KadrusBAG/VideoConverter/README.md

# VideoConverter
Video converter VGA, DVI-I, HDMI to RCA
