KadrusBAG/VideoConverter/Документация/Э1_Кудрявцев.pdf

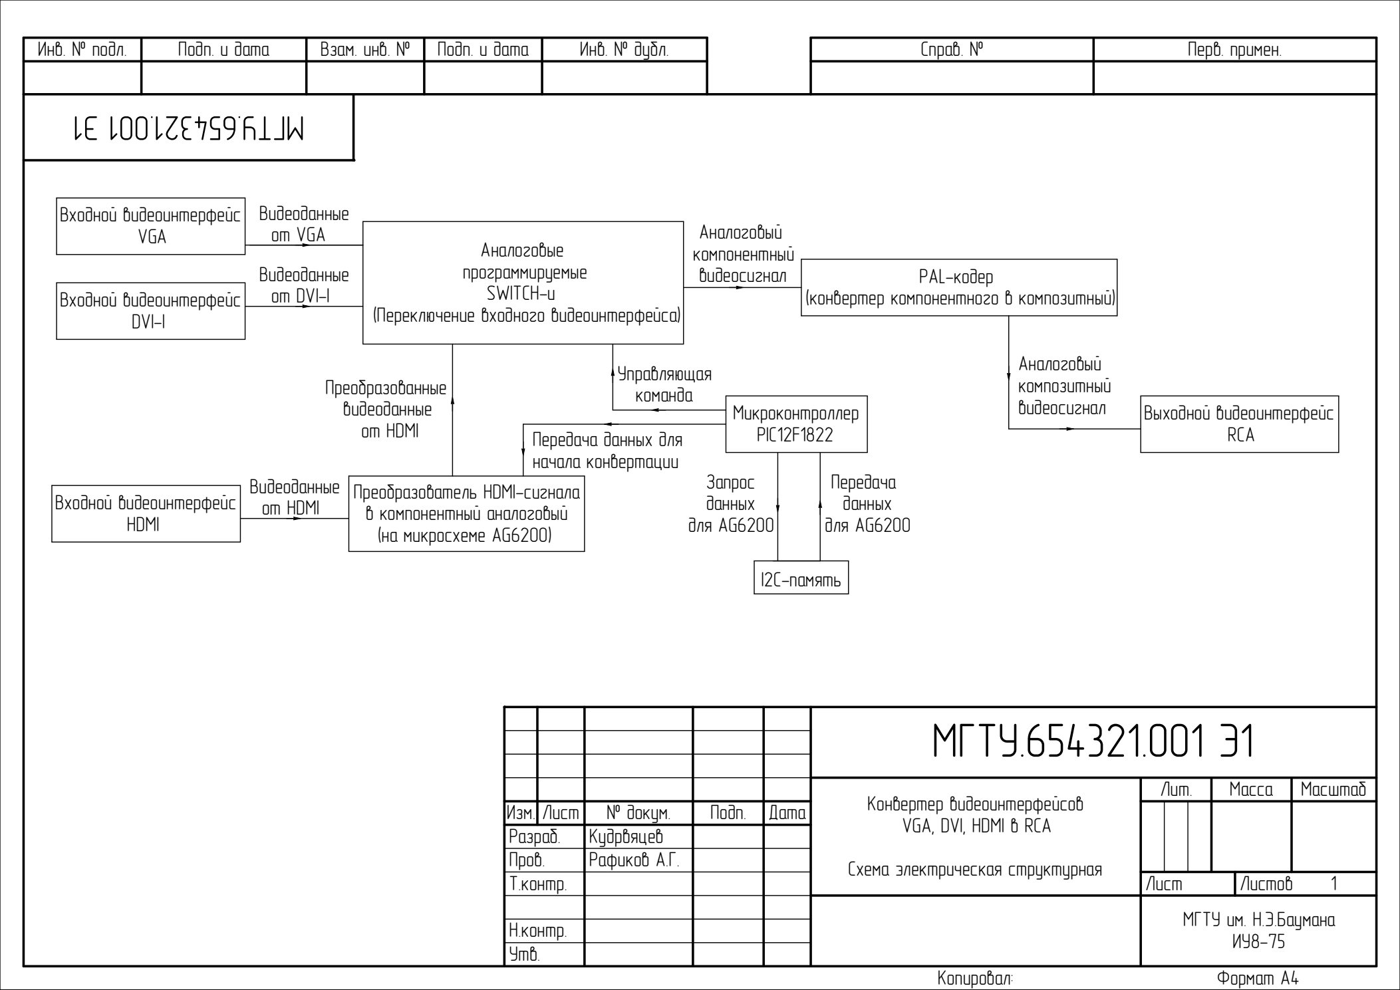
[picture p1: figure]
Разраб.; Кудрвяцев; Пров.; Рафиков А.Г.; МГТУ.654321.001 Э1; МГТУ им. Н.Э.Баумана ИУ8-75; Т.контр.; Лист; Листов 1; Изм. Лист; № докум.; Подп.; Дата; Н.контр. Утв.; Инв. № подл.; Подп. и дата; Взам. инв. №; Инв. № дубл.; Справ. №; Перв. примен.; Копировал:; Формат A4; Входной видеоинтерфейс VGA; Входной видеоинтерфейс DVI-I; Входной видеоинтерфейс HDMI; Микроконтроллер PIC12F1822; PAL-кодер (конвертер компонентного в композитный); Аналоговые программируемые SWITCH-и (Переключение входного видеоинтерфейса); I2C-память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

| | | | Конвертер видеоинтерфейсов VGA, DVI, HDMI в RCA Схема электрическая структурная | Лит. | Масса | Масштаб
