KadrusBAG/VideoConverter/Документация/БСА_Кудрявцев.pdf

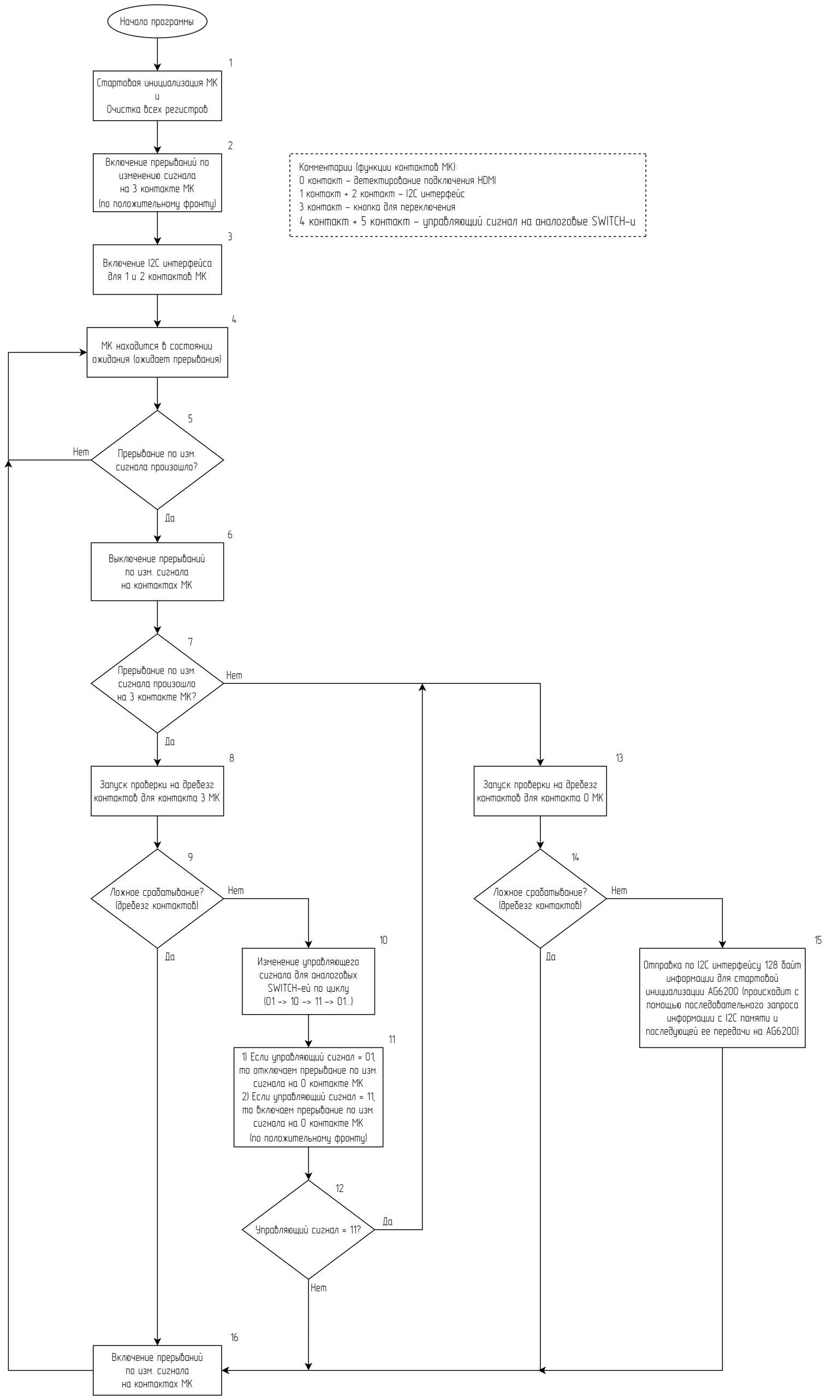
[picture p2: figure]

| | | | МГТУ.654321.001 БСА
| | | | Конвертер видеоинтерфейсов VGA, DVI, HDMI в RCA Схема электрическая прнципиальная | Лит. | Масса | Масштаб
Изм. Лист | № докум. | Подп. | Дата
Разраб. | Кудрявцев
| Пров. | Рафиков А.Г.
Т.контр. | | | | Лист | Листов 1
| | | | МГТУ им. Н.Э.Баумана ИУ8-75
Н.контр.
Утв.
Копировал: | Формат A4
