KadrusBAG/VideoConverter/Документация/ПЭ_Кудрявцев.pdf

Изм. | Лист | № докум. | Подп. | Дата
| | Разраб. | Кудрявцев Рафиков А.Г. | | Конвертер видеоинтерфейсов VGA, DVI, HDMI в RCA Перечень элементов
Пров. | | | | | | 1 3

Н.контр.
Утв.
Копировал | Формат А4

# МГТУ.654321.001 ПЭ

МГТУ им. Н.Э.Баумана
ИУ8-75
Лит. | Лист | Листов Инв. № подл. Подп. и дата Взам. инв. № Инв. № дубл. Подп. и дата Справ. № Перв. примен. | Зона | Поз.
обозначение
Наименование | Кол. | Примечание
| Конденсаторы
C1 | 10мкФ±20% 25В 0603 X5R GRM188R61E106M | 1
C2 | 0.1мкФ±10% 100В 1206 X7R GRM319R72A104KA01D | 1
C3, C4 | 22мкФ±10% 16В 1206 X5R GRM31CR61C226KE15L* | 2
C5 | 10мкФ±20% 25В 0603 X5R GRM188R61E106M | 1
C6 | 0.1мкФ±10% 100В 1206 X7R GRM319R72A104KA01D | 1
C7, C8 | 22мкФ±10% 16В 1206 X5R GRM31CR61C226KE15L* | 2
C9, C10 | 22мкФ±20% 100В ECAP (К50-35) JRB2A220M025006301 | 2 | Конд. электролит.
C11...C14 | 0.1мкФ±10% 100В 1206 X7R GRM319R72A104KA01D | 4
C15 | 220мкФ±20% 100В ECAP (К50-35) JRB2A221M0500130025 | 1 | Конд. электролит.
C16 | 10мкФ±20% 100В ECAP (К50-35) JRB2A100M0250063012 | 1 | Конд. электролит.
C17 | 0.1мкФ±20% 63В WCAP-ATG5 С860020772001 | 1 | Конд. электролит.
C18 | 47пФ±2% 100В 0603 COG GRM1885C2A470GA01D* | 1
C19 | 47мкФ±20% 10В ECAP (К50-35) JRB1A470M0200050011 | 1 | Конд. электролит.
C20, C21 | 10нФ±10% 100В 0603 X7R GRM188R72A103KA01D | 2
C22 | 47мкФ±20% 10В ECAP (К50-35) JRB1A470M0200050011 | 1 | Конд. электролит.
C23 | 0.1мкФ±10% 100В 1206 X7R GRM319R72A104KA01D | 1
C24 | 150пФ±5% 50В 0805 NPO GRM2165C1H151J | 1
C25 | 100пФ±5% 50В 0805 NPO GRM2165C1H101J | 1
C26 | 1мкФ±10% 25В 0603 X7R GRM188R71E105KA12D | 1
C27 | 10мкФ±20% 25В 0603 X5R GRM188R61E106M | 1
C28 | 0.1мкФ±10% 100В 1206 X7R GRM319R72A104KA01D | 1
C29 | 1мкФ±10% 25В 0603 X7R GRM188R71E105KA12D | 1
C30 | 10мкФ±20% 25В 0603 X5R GRM188R61E106M | 1
C31 | 1мкФ±10% 25В 0603 X7R GRM188R71E105KA12D | 1
C32 | 0.1мкФ±10% 100В 1206 X7R GRM319R72A104KA01D | 1
C33 | 4.7мкФ±10% 25В 0805 X5R GRM21BR61E475KA12L | 1

Изм. | Лист | № докум. | Подп. | Дата
МГТУ.654321.001 ПЭ | Лист Инв. № подл. Подп. и дата Взам. инв. № Инв. № дубл. Подп. и дата | 2 Зона | Поз.
| Микросхемы цифровые
DD1 | Quad 2-input exclusive-OR Gate SN74LS86AN С9000004797
DD2 | Микроконтроллер PIC12F1822-I/SN С9000161601
DD3 | Энергозависимая память AT24C01B-PU С9000057151
DD4 | Декодер 2в4 SN74LVC1G139DCTR С8005010195
FU1 | Предохранитель 6В 1.5А miniSMDC150F-2 | SMD15F/33-2
HL1...HL3 | Светодиоды 20мА GNL-3012ED | C9000422971
| Катушки индуктивности
L1 | 4.7 мкГн, 2.5 А, 7X7, EPCOS SMD B82472G6472M000
L2 | 2.2 мкГн, 6.5 А, 10X10, EPCOS SMD B82464G4222M
Q1 | Кварц. резонатор 4.43 МГц HC-49U | С4.433619MHzHC-49U
| Резисторы
R1, R4 | 100кОм±5% SMD 2512 С8004031180 | 2
R2 | 31.6кОм±1% SMD 0805 C8004212638 | 1
R3, R6 | 10.2кОм±1% SMD 0805 C8004212622 | 2
R5 | 4.99кОм±1% SMD 0805 C8004210860 | 1
R7, R8, R12 | 2.2кОм±5% СП3-4БМ С9000175834 | 3 | Резистор перемен.
R9, R10, R11 | 1кОм±10% СП3-19Б С8004213579 | 3 | Резистор перемен.
R13 | 75 Ом±1% SMD 0402 RC0402FR-0775RL | 1
R14 | 16кОм±1% SMD 0402 0402WGF1602TCE | 1
R15 | 47кОм±5% SMD 0402 0402WGJ0473TCE | 1
R16 | 510 Ом±1% SMD 0402 RC0402FR-07510RL | 1
R17, R19 | 10кОм±5% SMD 0805 0805W8J0103T5E | 2
R18 | 1.5кОм±1% SMD 0402 0402WGF1501TCE | 1
R20...R22 | 10кОм±5% SMD 0805 0805W8J0103T5E | 3

Изм. | Лист | № докум. | Подп. | Дата
МГТУ.654321.001 ПЭ | Лист Инв. № подл. Подп. и дата Взам. инв. № Инв. № дубл. Подп. и дата | 3 Зона | Поз.
R23, R25 | 100кОм±5% SMD 2512 С8004031180 | 2
R24, R26 | 10кОм±5% SMD 0805 0805W8J0103T5E | 2
R27 | 4.7кОм±5% SMD 0402 0402WGJ0472TCE | 1
R28...R30 | 270 Ом±1% SMD 0402 RC0402FR-07270RL | 3
VD1...VD3 | Диоды Шоттки 40В 1А/25А 1N5819 | C9000442595 | 3
VT1 | NPN транзистор 45В 0.2А 0.33Вт BC847B | C17914289 | 1
| Микросхемы
U1, U2 | Импульсные стабилизатор ADP2301AUJZ-R7 8002074924 | 2
U3, U4 | Quad analog switch TS5V330CPWR C8003189524 | 2
U5 | Преобразователь компон. аналог. видеосигнала CXA1645 | 1
U6, U7 | Analog switch SN74LVC1G3157DBVR C9000060303 | 2
U8 | Преобразователь цифр. HDMI-сигнала AG6200 | 1
SB1 | Кнопка B3F-3100 OMRON | V79:2366_21808240 | 1
