KadrusBAG/VideoConverter/Документация/СБ_Кудрявцев.pdf

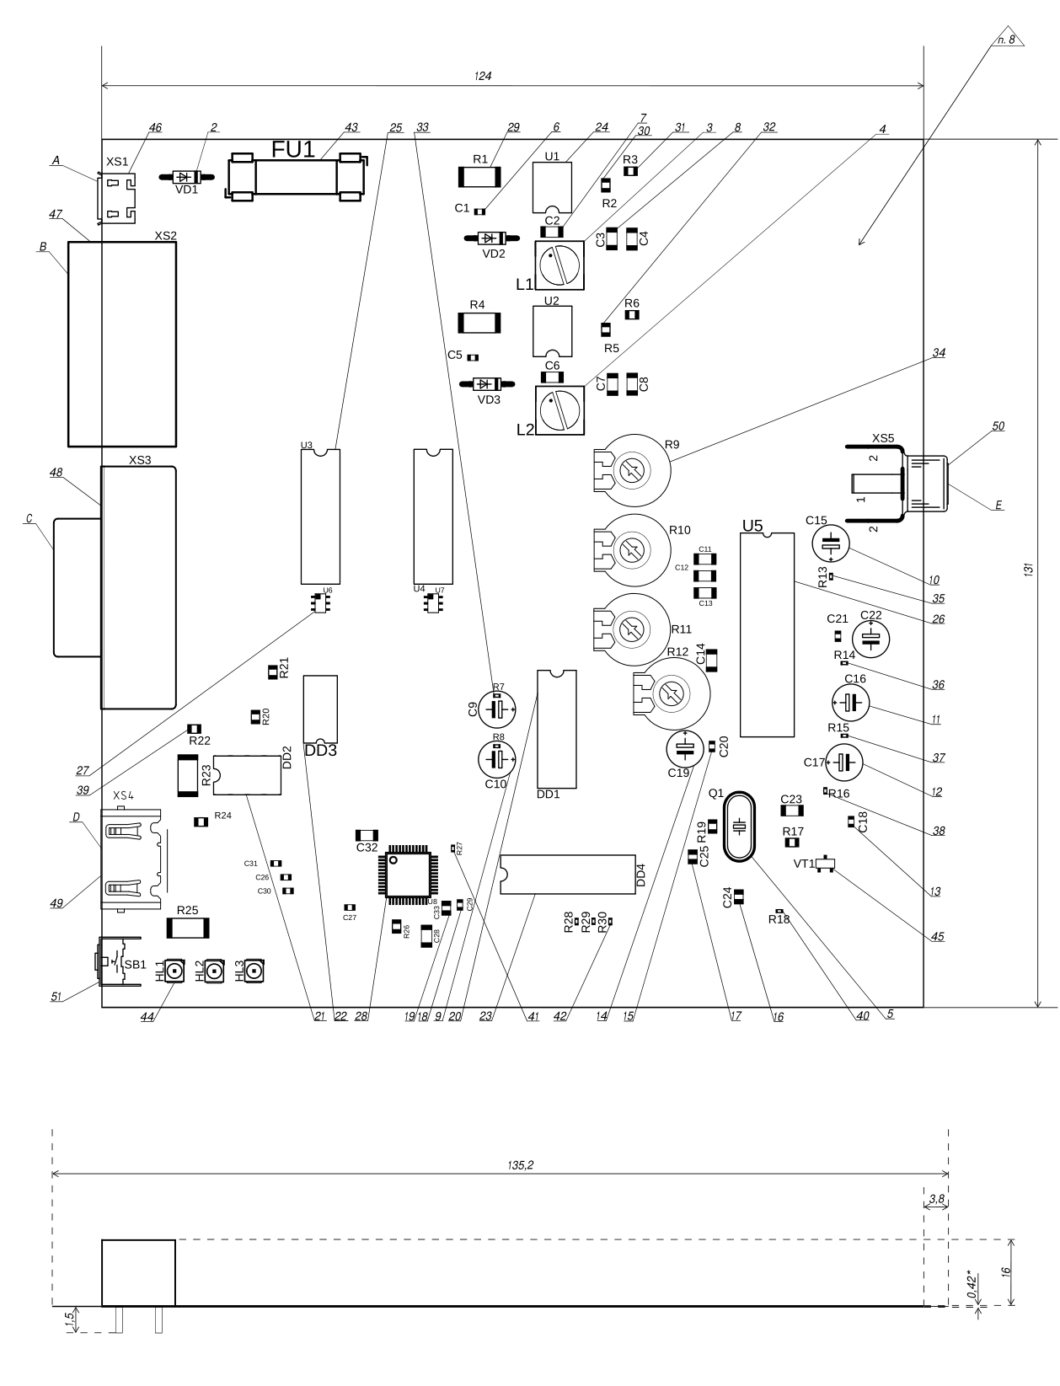
[picture p4: figure]

| | | | МГТУ.654321.001 СБ
| | | | Конвертер видеоинтерфесов VGA, DVI, HDMI в RCA Сборочный чертеж | Лит. | Масса | Масштаб
Изм. Лист | № докум. | Подп. | Дата | | | | | 2:1
Разраб. | Кудрявцев
Пров. | Рафиков А.Г.
Т.контр. | | | | Лист | Листов 1
| | | | МГТУ им. Н.Э.Баумана ИУ8-75
Н.контр.
Утв.
Копировал: | Формат A3
1. *Размеры для справок

2. Габаритные размеры по наибольшим размерам выступающих деталей 3. Монтаж выполнить согласно схеме электрической принципиальной 4. Установку КМП выполнять согласно ГОСТ Р МЭК 61192-1-2010 5. Высота выступающих концов выводов должно быть не более 0.5 мм 6. Печатные проводники условно не показаны 7. Пайку планарных соединений производить согласно ГОСТ 23592-96 8. Пайку объемных соединений производить ПОС-61 ГОСТ 21930-76 согласно ГОСТ 23592-96 9. Контроль пояльных соединений производить визуально оптическим методом
10. Зоны A, B, C, D, E защитить резиновым клеем ИКФ-130 ТУ 38.1051056-82 от попадания лака

### 11. Плату покрыть лаком URETHAN 71 пневматическим распылением в один слой 12. Маркировать заводской номер шрифт 2,5-Пр3 26.020-80 ПФ-115 белая ГОСТ 6465-76 УХ/12 13. Остальные технические требования по ГОСТ Р 56427-2015
