KadrusBAG/VideoConverter/Документация/СПЦ_Кудрявцев.pdf

Изм. | Лист | № докум. | Подп. | Дата
| | Разраб. | Кудрявцев Рафиков А.Г. | | Конвертер видеоинтерфейсов VGA, DVI, HDMI в RCA Спецификация
Пров. | | | | | | 1 6

Н.контр.
Утв.
Копировал | Формат А4

# МГТУ.654321.001 СПЦ

МГТУ им. Н.Э.Баумана
ИУ8-75
Лит. | Лист | Листов Инв. № подл. Подп. и дата Взам. инв. № Инв. № дубл. Подп. и дата Справ. № Перв. примен. | Формат | Зона | Поз. | Обозначение | Наименование | Кол. | Примечание

Документация

А4 | МГТУ.654321.001 ТЗ | Техническое задание
А4 | МГТУ.654321.001 СБ | Сборочный чертеж
А4 | МГТУ.654321.001 Э1 | Схема электрическая структурная
А1 | МГТУ.654321.001 ЭЗ | Схема электрическая принципиальная
А4 | МГТУ.654321.001 ИТП | Исходные тексты программ
А4 | МГТУ.654321.001 ПЭ | Перечень эленментов
А4 | МГТУ.654321.001 ОП | Описание программ
А4 | МГТУ.654321.001 БСА | Блок-схема алгоритма
А4 | МГТУ.654321.001 РПЗ | Расчетно-пояснительная записка

Детали

А3 | 1 | МГТУ.654321.002 | Плата печатная | 1
2 | 1N5819 | 3 | VD1...VD3
| Диоды Шоттки (40В 1А/25А) ST Microelectronics

Катушки индуктивности

3 | 7X7 SMD | 1 | L1
| (4.7 мкГн, 2.5 А) EPCOS
4 | 10X10 SMD | 1 | L2
| (2.2 мкГн, 6.5 А) EPCOS

Изм. | Лист | № докум. | Подп. | Дата
МГТУ.654321.001 СПЦ | Лист Инв. № подл. Подп. и дата Взам. инв. № Инв. № дубл. Подп. и дата | 2 Формат | Зона | Поз. | Обозначение | Наименование | Кол. | Примечание
5 | HC-49U | 1 | Q1
| Кварц. резонатор (4.43 МГц) Китай

Конденсаторы

6 | 0603 X5R | 4 | C1, C5
| (10мкФ±20%) Murata Manufacturing | | C27, C30
7 | 1206 X7R | | C2, C6
| (0.1мкФ±10%) Murata Manufacturing | | C11...C14
| | 9 C23, C28, C32
8 | 1206 X5R | 4 | C3, C4
| (22мкФ±10%) Murata Manufacturing | | C7, C8
9 | ECAP (К50-35) | 2 | C9, C10
| (22мкФ±20%) JB
10 | ECAP (К50-35) | 1 | C15
| (220мкФ±20%) JB
11 | ECAP (К50-35) | 1 | C16
| (10мкФ±20%) JB
12 | WCAP-ATG5 | 1 | С17
| (0.1мкФ±20%) Wurth Elektronik
13 | 0603 COG | 1 | С18
| (47пФ±20%) Murata Manufacturing

МГТУ.654321.001 СПЦ | Лист Инв. № подл. Подп. и дата Взам. инв. № Инв. № дубл. Подп. и дата | 3 Формат | Зона | Поз. | Обозначение | Наименование | Кол. | Примечание
14 | ECAP (К50-35) | 2 | C19, C22
| (47мкФ±20%) JB
15 | 0603 X7R | 2 | C20, C21
| (10нФ±10%) Murata Manufacturing
16 | 0805 NPO | 1 | C24
| (150пФ±5%) Murata Manufacturing
17 | 0805 NPO | 1 | C25
| (100пФ±5%) Murata Manufacturing
18 | 0603 X7R | 3 | C26, C29, C31
| (1мкФ±10%) Murata Manufacturing
19 | 0805 X5R | 1 | C33
| (4.7мкФ±10%) Murata Manufacturing

Микросхемы

20 | SN74LS86AN | 1 | DD1
| (Quad 2-input exclusive-OR Gate) Texas Instruments
21 | PIC12F1822-I/SN | 1 | DD2
| (MCU) Microchip Technology
22 | AT24C01B-PU | 1 | DD3
| (I2C EEPROM) Atmel

МГТУ.654321.001 СПЦ | Лист Инв. № подл. Подп. и дата Взам. инв. № Инв. № дубл. Подп. и дата | 4 Формат | Зона | Поз. | Обозначение | Наименование | Кол. | Примечание
23 | SN74LVC1G139DCTR | 1 | DD4
| (Decoder) Texas Instruments
24 | ADP2301AUJZ-R7 | 2 | U1, U2
| (Стабилизатор напряжения) Analog Devices
| | 2
25 | TS5V330CPWR | | U3, U4
| (Analog switch) Texas Instruments
26 | CXA1645 | 1 | U5
| (Преобразователь компон. аналог. видеосигнала)
27 | SN74LVC1G3157DBVR | 2 | U6, U7
| (Analog switch) Texas Instruments
28 | AG6200 | 1 | U8
| (Преобразователь цифр. HDMI-сигнала)

Резисторы

29 | SMD 2512 | 4 | R1, R4
| (100кОм±5%) Тайвань | | R23, R25
30 | SMD 0805 | 1 | R2
| (31.6кОм±1%) Тайвань
31 | SMD 0805 | 2 | R3, R6
| (10.2кОм±1%) Тайвань

МГТУ.654321.001 СПЦ | Лист Инв. № подл. Подп. и дата Взам. инв. № Инв. № дубл. Подп. и дата | 5 Формат | Зона | Поз. | Обозначение | Наименование | Кол. | Примечание
32 | SMD 0805 | R5
| (4.99кОм±1%) Тайвань
33 | СП3-4БМ | 3 | R7, R8, R12
| (2.2кОм±5%) Россия
34 | СП3-19Б | 3 | R9, R10, R11
| (1кОм±10%) Россия
35 | SMD 0402 | R13
| (75 Ом±1%) Тайвань
36 | SMD 0402 | 1 | R14
| (16кОм±1%) Тайвань
37 | SMD 0402 | 1 | R15
| (47кОм±5%) Тайвань
38 | SMD 0402 | 1 | R16
| (510 Ом±1%) Тайвань
39 | SMD 0805 | | R17, R19
| (10кОм±5%) Тайвань | | R20...R22
| | 7 R24, R26
40 | SMD 0402 | 1 | R18
| (1.5кОм±1%) Тайвань
41 | SMD 0402 | 1 | R27
| (4.7кОм±5%) Тайвань

МГТУ.654321.001 СПЦ | Лист Инв. № подл. Подп. и дата Взам. инв. № Инв. № дубл. Подп. и дата | 6 Формат | Зона | Поз. | Обозначение | Наименование | Кол. | Примечание
42 | SMD 0402 | 3 | R28...R30
| (270 Ом±1%) Тайвань
43 | miniSMDC150F-2 | 1 | FU1
| Предохранитель (6В 1.5А) Littelfuse
44 | GNL-3012ED | 3 | HL1...HL3
| Светодиоды (20мА) G-nor Electronics
45 | BC847B | 1 | VT1
| Транзистор (45В 0.2А 0.33Вт) Nexperia

Разъемы

46 | Micro-USB type B | 1 | XS1
47 | VGA (Видеоразъем) | 1 | XS2
48 | DVI-I (Видеоразъем) | 1 | XS3
49 | HDMI (Видеоразъем) | 1 | XS4
50 | RCA jack (Видеоразъем) | 1 | XS5
51 | B3F-3100 | 1 | SB1
| Кнопка (Omron)
