KadrusBAG/VideoConverter/Документация/Э3_Кудрявцев.pdf

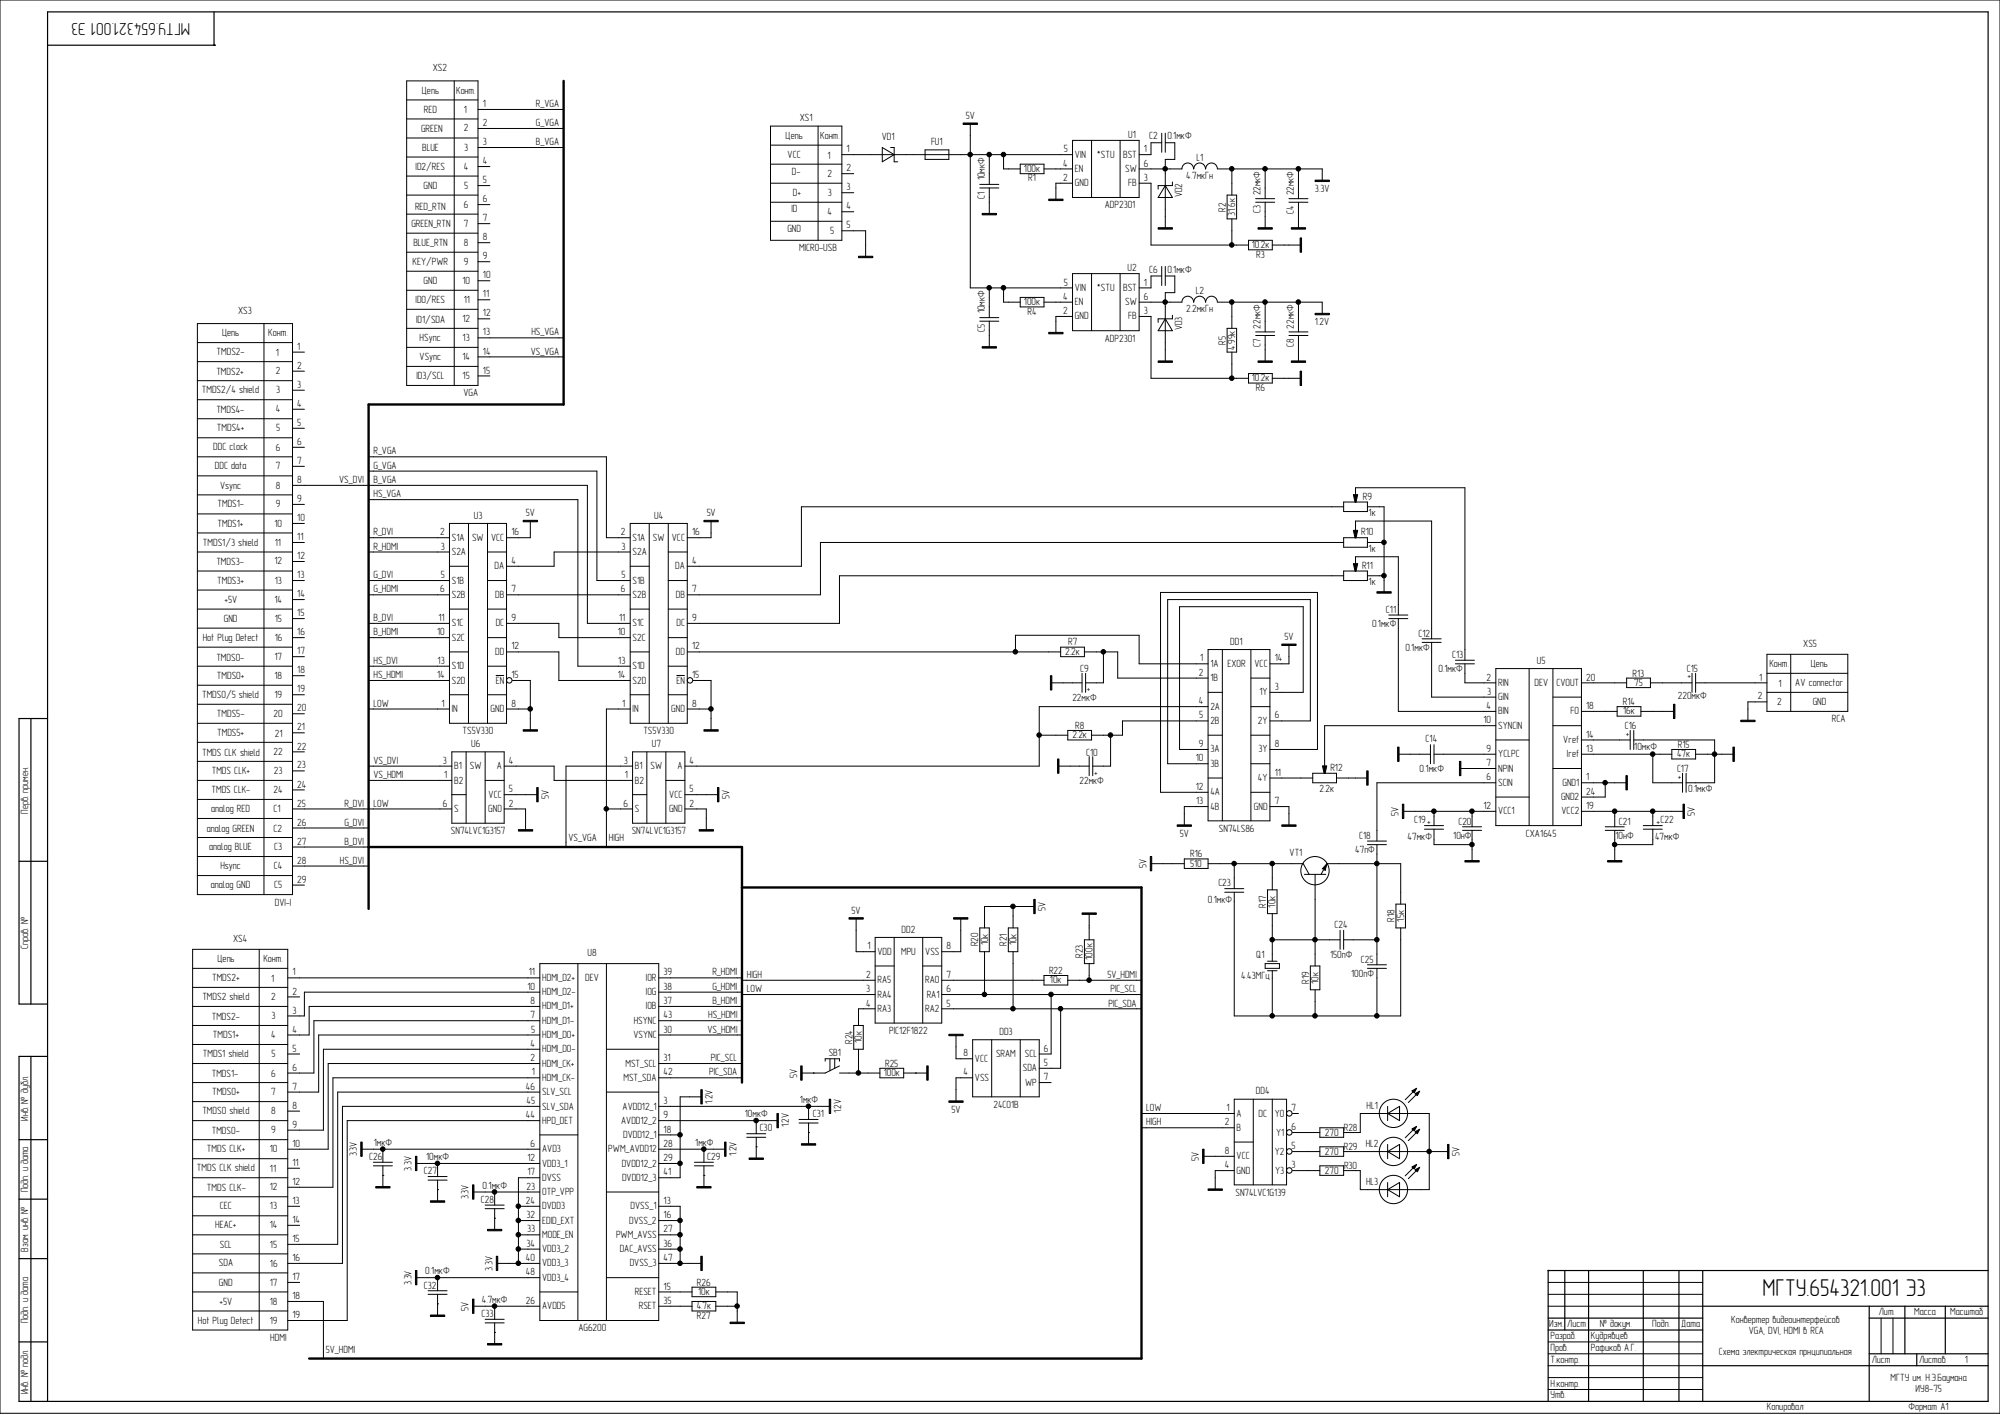
[picture p5: page 1]

Цепь | Конт.
RED | 1
GREEN | 2

BLUE_RTN | 8
KEY/PWR | 9

TMDS2/4 shield | 3 | VGA
TMDS4- | 4
TMDS4+ | 5
DDC clock | 6

analog GREEN | C2
analog BLUE | C3

38 IOG G_HDMI | LOW 3 | 6 | 10к | PIC_SCL

TMDS2 shield | 2 | 3 | 8 | 37 IOB B_HDMI | 4 | PIC_SDA
TMDS2- | 3 | | 7 | 43 HSYNC HS_HDMI

Конвертер видеоинтерфейсов
VGA, DVI, HDMI в RCA

Разраб. | Кудрявцев
Пров. | Рафиков А.Г.
Т.контр. | | Лист | Листов 1

Н.контр.
Утв.

МГТУ им. Н.Э.Баумана ИУ8-75
