KadrusBAG/VideoConverter/(list of files, drawings)

Other design files:
Моделирование/PIC12F1822-WORK.pdsprj
