KadrusBAG/VideoConverter/Разводка ПП/Converter/Scheme.brd

## EAGLE design Разводка ПП/Converter/Scheme.brd (2021-03-14)

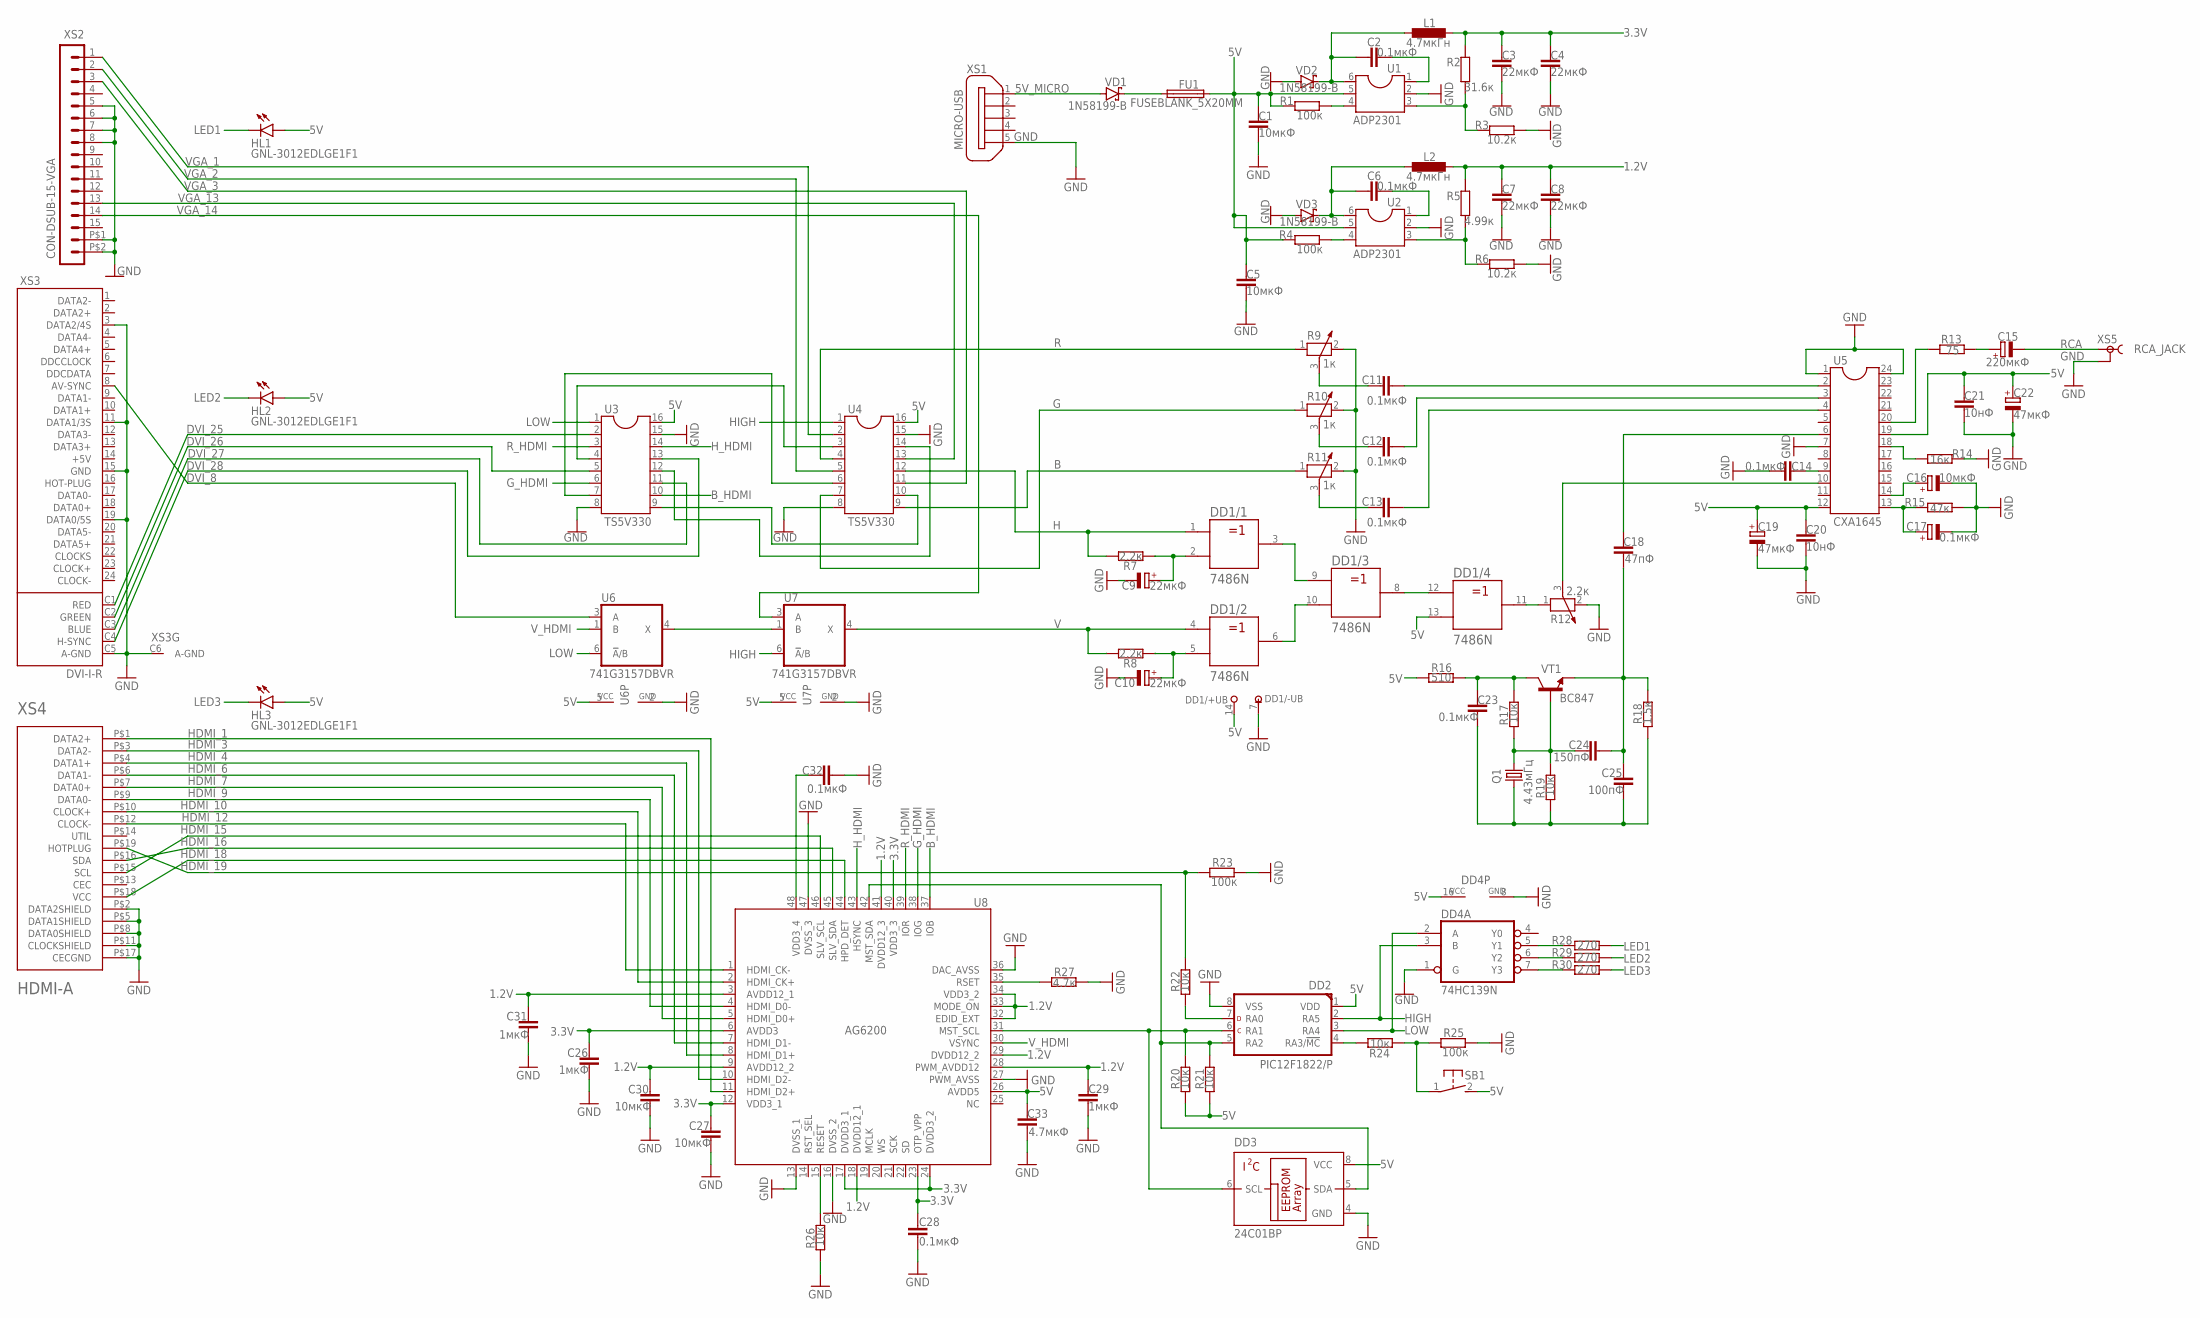
[picture p6: schematic Scheme.sch]

Parts:
C1, C5, C27, C30: 10мкФ; C0603
C2, C6, C11, C12, C13, C14, C23, C28, C32: 0.1мкФ; C1206
C3, C4, C7, C8: 22мкФ; C1206
C9, C10: 22мкФ; E2,5-6E
C15: 220мкФ; E2,5-6E
C16: 10мкФ; E2,5-6E
C17: 0.1мкФ; E2,5-6E
C18: 47пФ; C0603
C19, C22: 47мкФ; E2,5-6E
C20, C21: 10нФ; C0603
C24: 150пФ; C0805
C25: 100пФ; C0805
C26, C29, C31: 1мкФ; C0603
C33: 4.7мкФ; C0805
DD1: 7486N; DIL14
DD2: PIC12F1822/P; DIL8-P
DD3: 24C01BP; DIL8
DD4: 74HC139N; DIL16
FU1: FUSEBLANK_5X20MM; FUSE_HOLDER_5X20MM
HL1, HL2, HL3: GNL-3012EDLGE1F1; PLCC2
L1, L2: 4.7мкГн; PIS2816
Q1: 4.43мГц; HC49U-V
R1, R4, R23, R25: 100к; R2512
R2: 31.6к; R0805
R3, R6: 10.2к; R0805
R5: 4.99к; R0805
R7, R8: 2.2к; R0402
R9, R10, R11: 1к; PT-10
R12: 2.2к; PT-10
R13: 75; R0402
R14: 16к; R0402
R15: 47к; R0402
R16: 510; R0402
R17, R19, R20, R21, R22, R24, R26: 10к; R0805
R18: 1.5к; R0402
R27: 4.7к; R0402
R28, R29, R30: 270; R0402
SB1: 31-XX; B3F-31XX
U1, U2: ADP2301; DIL06
U3, U4: TS5V330; DIL16
U5: CXA1645; DIL24-4
U6, U7: 741G3157DBVR; DBV_R-PDSO-G6
U8: AG6200; PLCC-48
VD1, VD2, VD3: 1N58199-B; DO41-7.6
VT1: BC847; SOT23-BEC
XS1: MICRO-USB; ZX62D-B-5PA8
XS2: CON-DSUB-15-VGA; 181-015-212-171
XS3: DVI-I-R
XS4: HDMI-A; HDMI_A
XS5: RCA_JACK; TOBU3

Connections:
1.2V: C7.1, C8.1, C29.1, C30.1, C31.1, L2.2, R5.2, U8.3 (AVDD12_1), U8.9 (AVDD12_2), U8.18 (DVDD12_1), U8.28 (PWM_AVDD12), U8.29 (DVDD12_2), U8.32 (EDID_EXT), U8.33 (MODE_ON), U8.34 (VDD3_2), U8.41 (DVDD12_3)
3.3V: C3.1, C4.1, C26.1, C27.1, C28.1, L1.2, R2.2, U8.6 (AVDD3), U8.12 (VDD3_1), U8.17 (DVDD3_1), U8.23 (OTP_VPP), U8.24 (DVDD3_2), U8.40 (VDD3_3)
5V: C1.1, C5.1, C19.+, C20.1, C21.1, C22.+, C33.1, DD1.13 (B), DD1.14 (+UB), DD2.1 (VDD), DD3.8 (VCC), DD4.16 (VCC), FU1.2, HL1.A, HL2.A, HL3.A, R1.1, R4.1, R16.1, R20.1, R21.1, SB1.2 (S), U1.5, U2.5, U3.16, U4.16, U5.12, U5.19, U6.5 (VCC), U7.5 (VCC), U8.26 (AVDD5)
5V_MICRO: VD1.A, XS1.1
+5V: XS3.14 (+5V)
B: R11.1, U4.9
B_HDMI: U3.10, U8.37 (IOB)
DVI_8: U6.3 (A), XS3.8 (AV-SYNC)
DVI_25: U3.2, XS3.C1 (RED)
DVI_26: U3.5, XS3.C2 (GREEN)
DVI_27: U3.11, XS3.C3 (BLUE)
DVI_28: U3.13, XS3.C4 (H-SYNC)
G: R10.1, U4.7
GND: C1.2, C3.2, C4.2, C5.2, C7.2, C8.2, C9.-, C10.-, C14.2, C16.-, C17.-, C19.-, C20.2, C21.2, C22.-, C26.2, C27.2, C28.2, C29.2, C30.2, C31.2, C32.2, C33.2, DD1.7 (-UB), DD2.8 (VSS), DD3.4 (GND), DD4.1 (G), DD4.8 (GND), R3.1, R6.1, R9.2, R10.2, R11.2, R12.2, R14.2, R15.2, R23.2, R25.2, R26.1, R27.2, U1.2, U2.2, U3.8, U3.15, U4.8, U4.15, U5.1, U5.7, U5.24, U6.2 (GND), U7.2 (GND), U8.13 (DVSS_1), U8.16 (DVSS_2), U8.27 (PWM_AVSS), U8.36 (DAC_AVSS), U8.47 (DVSS_3), VD2.A, VD3.A, XS1.5, XS2.5, XS2.6, XS2.7, XS2.8, XS2.P$1 (16), XS2.P$2 (17), XS3.3 (DATA2/4S), XS3.11 (DATA1/3S), XS3.15 (GND), XS3.19 (DATA0/5S), XS3.C5 (A-GND), XS3.C6 (A-GND), XS4.P$2 (DATA2SHIELD), XS4.P$5 (DATA1SHIELD), XS4.P$8 (DATA0SHIELD), XS4.P$11 (CLOCKSHIELD), XS4.P$17 (CECGND), XS5.2, XS5.2@1 (2), XS5.2@2 (2)
G_HDMI: U3.6, U8.38 (IOG)
H: DD1.1 (A), R7.1, U4.12
HDMI_1: U8.11 (HDMI_D2+), XS4.P$1 (DATA2+)
HDMI_3: U8.10 (HDMI_D2-), XS4.P$3 (DATA2-)
HDMI_4: U8.8 (HDMI_D1+), XS4.P$4 (DATA1+)
HDMI_6: U8.7 (HDMI_D1-), XS4.P$6 (DATA1-)
HDMI_7: U8.5 (HDMI_D0+), XS4.P$7 (DATA0+)
HDMI_9: U8.4 (HDMI_D0-), XS4.P$9 (DATA0-)
HDMI_10: U8.2 (HDMI_CK+), XS4.P$10 (CLOCK+)
HDMI_12: U8.1 (HDMI_CK-), XS4.P$12 (CLOCK-)
HDMI_15: U8.46 (SLV_SCL), XS4.P$15 (SCL)
HDMI_16: U8.45 (SLV_SDA), XS4.P$16 (SDA)
HDMI_18: U8.44 (HPD_DET), XS4.P$18 (VCC)
HDMI_19: R22.2, R23.1, XS4.P$19 (HOTPLUG)
HIGH: DD2.2 (RA5), DD4.3 (B), U4.1, U7.6 (!A!/B)
H_HDMI: U3.14, U8.43 (HSYNC)
LED1: HL1.C, R28.2
LED2: HL2.C, R29.2
LED3: HL3.C, R30.2
LOW: DD2.3 (RA4), DD4.2 (A), U3.1, U6.6 (!A!/B)
unnamed: FU1.1, VD1.C
unnamed: C9.+, DD1.2 (B), R7.2
unnamed: C2.1, L1.1, U1.6, VD2.C
unnamed: C10.+, DD1.5 (B), R8.2
unnamed: C2.2, U1.1
unnamed: R2.1, R3.2, U1.3
unnamed: R1.2, U1.4
unnamed: C6.1, L2.1, U2.6, VD3.C
unnamed: C6.2, U2.1
unnamed: R5.1, R6.2, U2.3
unnamed: DD4.5 (Y1), R28.1
unnamed: R4.2, U2.4
unnamed: C11.2, U5.2
unnamed: DD1.3 (Y), DD1.9 (A)
unnamed: DD1.6 (Y), DD1.10 (B)
unnamed: C12.2, U5.3
unnamed: DD1.8 (Y), DD1.12 (A)
unnamed: DD1.11 (Y), R12.1
unnamed: C11.1, R9.3
unnamed: C12.1, R10.3
unnamed: C13.1, R11.3
unnamed: C13.2, U5.4
unnamed: R12.3, U5.10
unnamed: C23.1, R16.2, R17.2, VT1.C
unnamed: C23.2, C25.2, Q1.2, R18.1, R19.1
unnamed: C24.1, Q1.1, R17.1, R19.2, VT1.B
unnamed: C18.2, C24.2, C25.1, R18.2, VT1.E
unnamed: C18.1, U5.6
unnamed: DD4.6 (Y2), R29.1
unnamed: C14.1, U5.9
unnamed: DD4.7 (Y3), R30.1
unnamed: C17.+, R15.1, U5.13
unnamed: C16.+, U5.14
unnamed: R14.1, U5.18
unnamed: R13.1, U5.20
unnamed: U6.4 (X), U7.1 (B)
unnamed: C15.+, R13.2
unnamed: U3.4, U4.3
unnamed: U3.7, U4.6
unnamed: U3.9, U4.10
unnamed: C32.1, U8.48 (VDD3_4)
unnamed: U3.12, U4.14
unnamed: R26.2, U8.15 (RESET)
unnamed: R27.1, U8.35 (RSET)
unnamed: DD2.6 (RA1), DD3.6 (SCL), R20.2, U8.31 (MST_SCL)
unnamed: DD2.5 (RA2), DD3.5 (SDA), R21.2, U8.42 (MST_SDA)
unnamed: DD2.7 (RA0), R22.1
unnamed: DD2.4 (RA3/!MC!), R24.2
unnamed: R24.1, R25.1, SB1.1
R: R9.1, U4.4
RCA: C15.-, XS5.1
R_HDMI: U3.3, U8.39 (IOR)
V: DD1.4 (A), R8.1, U7.4 (X)
VGA_1: U4.2, XS2.1
VGA_2: U4.5, XS2.2
VGA_3: U4.11, XS2.3
VGA_13: U4.13, XS2.13
VGA_14: U7.3 (A), XS2.14
V_HDMI: U6.1 (B), U8.30 (VSYNC)

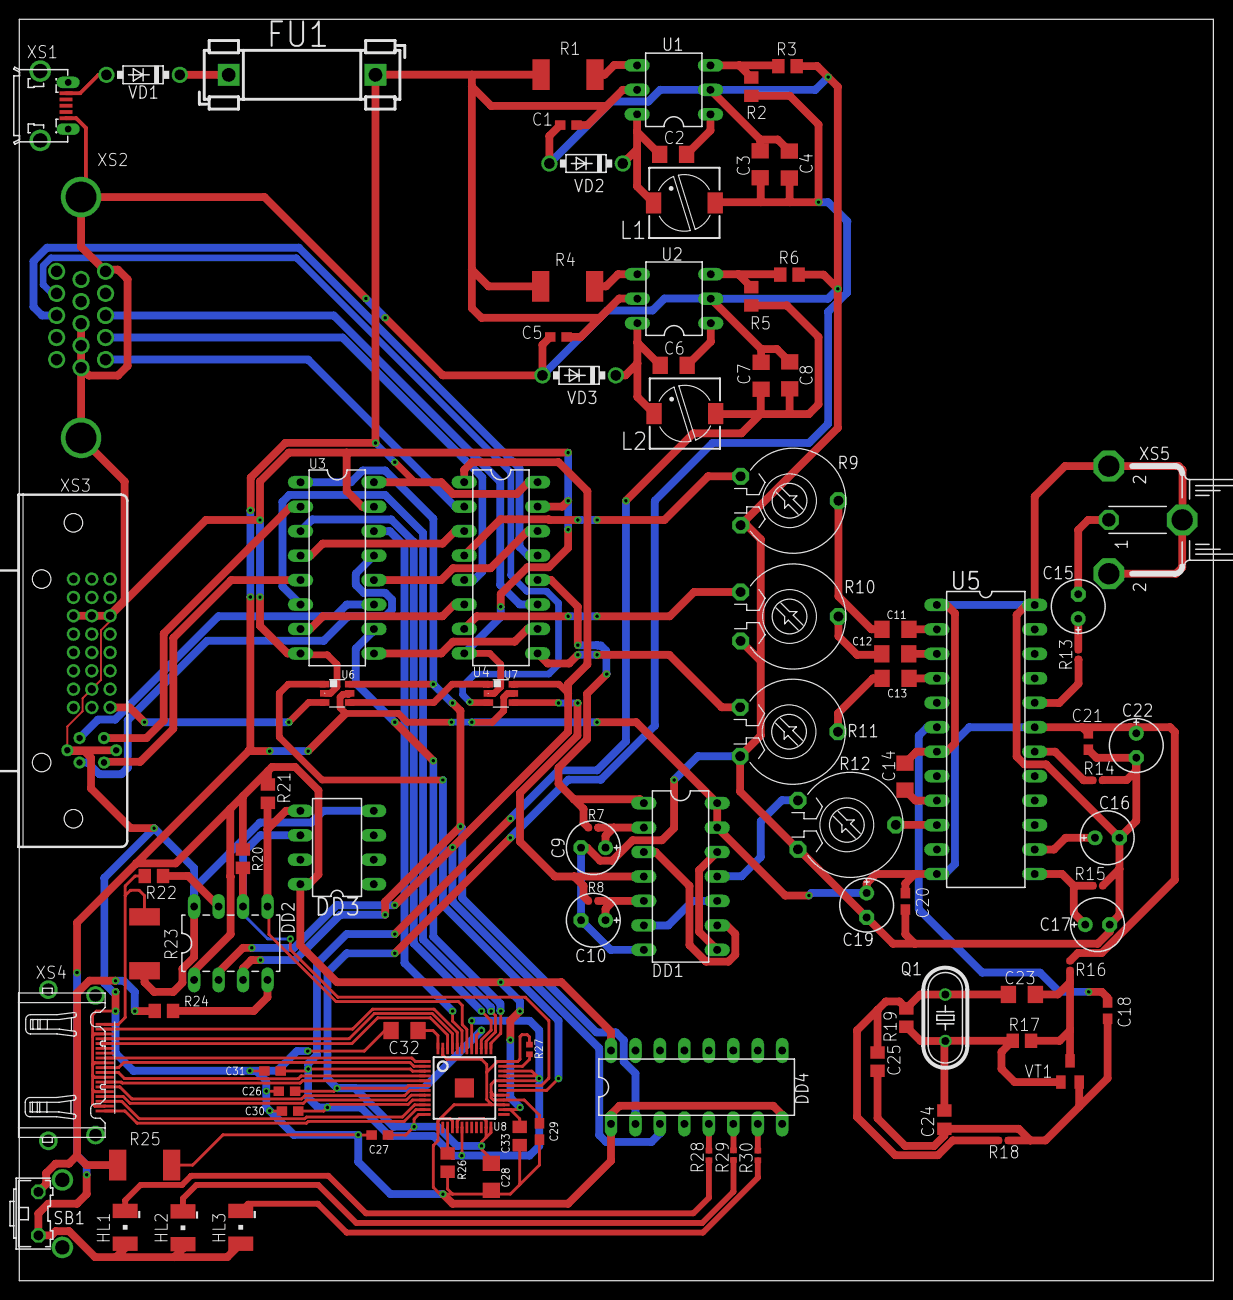
[picture p7: board Scheme.brd from above]

Board: 2 copper layers, 124.0 x 131.0 mm, 92 parts (0 on the bottom side), 92 nets.
